Simmetopia/semester_02/README.md

# semester_02
2016 Semester Project for 10

# 07-10-2016 - 
###SIMON
  Jeg har nu lagt vores GUI op på git. Lav endelig pull requests hvis i finder noget som enten bygger videre, eller gør det bedre.
# 27-11-2016
###Simon og Emil
Lidt opdateret GUI(mangler megetarbejde endnu). Vi har lavet vores seriel kommunikation og lidt af logikken som skal være på arduinoen.
##TO DO:
1. Vi skal have lavet logikken færdig til arduino programmet
2. Protocollen skal skrives færdig
     
[Hent denne pakke til Arduinos IDE](https://github.com/maniacbug/StandardCplusplus)
   
eksempel på en streng hvor der skal tændes for 3 elementer:
"!,S,1,12:45,N,3,12:55,N,6,13:15\n"

#29-11-2016
###Simon
skrevet mere til PC program(se PCkode), som nu kan oprette scenarier og gemme dem i en dynamisk vector.
##TO DO mere her:
1. denne opsættelses process skal kunne gennem den streng vi modtager.
2. den skal også kunne oprette en streng som sendes serielt.
