Simmetopia/semester_02/Rapport/simon_rapport.tex

\documentclass[11pt]{article}
\usepackage{graphicx}
\usepackage{siunitx}
\usepackage{cleveref}
\usepackage{keyval,kvoptions,fancyvrb,float,ifthen,calc,ifplatform,pdftexcmds,etoolbox,lineno}
\usepackage[utf8]{inputenc}
\usepackage[danish]{babel}
\usepackage[left=25mm, right=25mm, top=25mm, bottom=25mm]{geometry}
\usepackage{amsthm}
\setlength\parindent{0pt}
\usepackage{dcolumn}
\usepackage{minted}
\usepackage{setspace}

\title{Rapport}

\begin{document}

\maketitle
\section*{Resumé}
\vfill
\pagebreak

\section*{Abstract}
\vfill
\pagebreak

\tableofcontents
\vfill
\pagebreak

\section{Forord}
\vfill
\pagebreak

\section{Indledning}
\vfill
\pagebreak
\section{Projektformulering \& Afgrænsning}
%Tabeloversigt over hovedansvarsområder for projektdeltagerne
\vfill
\pagebreak

\section{Systembeskrivelse}
\vfill
\pagebreak

\section{Krav}
\vfill
\pagebreak

\section{Smart Morning System (SMS) - Projekt Beskrivelse}
\subsection{Projektgennemførelsen}
\subsection{Metode}
\subsection{Specifikation \& Analyse}
\subsection{Arkitektur}
\subsection{Design, Implementering \& Test (HW/SW)}
\subsection{Resultater \& Diskussion}
\subsection{Opnåede erfaringer}
\subsection{Fremtidigt arbejde \& Perspektivering}
\vfill
\pagebreak

\section{Konklusion}
\vfill
\pagebreak

\section{Referencer}
\vfill
\pagebreak

\end{document}
