Simmetopia/semester_02/Rapport/ChristianLatex/DokumentationIndledning.pdf

## hahahaahah grimme

Christian Bondesen - 201511621

4. januar 2017

## 1 Indledning

Smart Morning System er et system der vil gøre det lettere for den almene dansker, at f˚a en dejlig morgen. Systemet vil best˚a af nogle forskellige hardware- og softwaredele. Dette produkt vil best˚a af en PC-applikation, en X-10 modtager og en X-10 sender og et DE2 board. X-10 hardware- og softwaren vil følge X-10 protokol¹
, yderligere er de ogs˚a tilkoblet lysnettet p˚a forbrugerens hjem. Det er ogs˚a tilgængeligt at bruge en Graphical User Interface til at styre et brugervalgt scenarie. Disse scenarier kan best˚a af forskellige enheder eksempelvis, en lampe, en radio eller en kaffemaskine. Det vil ogs˚a være muligt at sætte alle enheder sammen og definere et specifikt tidspunkt hvorp˚a det scenarie vil p˚abegyndes til valgte tidspunkt.

## Læsevejledning

For at kunne læse og forst˚a denne projektdokumentation, anbefales det at følgende vejledning. Mange udtryk, forkortelse og sprogligevendinger er beskrevet herunder. Det vil gøre det mere overskueligt og skaber bedre forst˚aelse.

1
indsæt

1

Term | Beskrivelse | Surrogat
X-10 modtager | X-10 protokolens modtagerdel der læ- ser p˚a lysnettet og signalere til ATme- ga2560 om der er et logisk højt eller lavt | Modtager, 120 kHz Carrier-detector
X-10 sender | X-10 protokolens senderderdel der sen- der en bitkode sikkert ud p˚a lysnettet | Generator, 120 kHz carrier-generator
GUI | Graphical User Interface | brugerflade, Grafisk brugerflade
Zero-cross | X-10 protokolens Zero-cross detector, den der detekterer hvert zero cross p˚a lysnettet | ZeroX
burst | 120 kHz sendes fra ATmega2560 eller Analog-Discovery | 120 kHz
Arduino | Microcontrollerne til modtager og sen- der | ATmega2560, Microcontroller
Lysnet | 18VAC signal | El-nettet
Nulgennemgang | Hvergang der sinussignalet rammer 0 | zero cross

Tabel 1: Tabel over termer der fremmer forst˚aelse hos læseren af projektdokumentation

2
