Simmetopia/semester_02/Dokumentation/Dokumentation.pdf

Aarhus School of Engineering

2.SEMESTERPROJEKT

E2PRJ2

gruppe 10

# Smart Morning System - SMS

20. december 2016

Forfattere:
201511621 Christian Brandstrup Bondesen 201511621 Emil Celik
201408914 Marc Auphong Bui
2015xxxxx Rasmus Lund
201406253 Simon Egeberg

Vejleder:
Kim Bjerge


## Indhold

1 Indledning | 2
2 Kravspecifikation | 3
3 Arkitektur | 4
4 Hardware-design, implementering & modultest | 5
5 Software-design, implementering & modultest | 6
6 Integrationstest (HW/SW) | 7
7 Accepttest | 8
8 Bilag | 9

## 1 Indledning

## 2 Kravspecifikation

## 3 Arkitektur

## 4 Hardware-design, implementering & modultest

### 4.1 Design (HW)

### 4.2 Implementering (HW)

### 4.3 Modultest (HW)

## 5 Software-design, implementering & modultest

### 5.1 Design (SW)

### 5.2 Implementering (SW)

### 5.3 Modultest (SW)

## 6 Integrationstest (HW/SW)

## 7 Accepttest

## 8 Bilag
