Simmetopia/semester_02/(threads)

Thread 50 (2016-12-14):

burstOn(); - skal den være i en seperat .h fil?

donbuibui, 2016-12-14:
Jeg tænkte på om den overhovedet kunne kaldes hvis den er inde i ReadASCIIString.ino.ino

Simmetopia, 2016-12-15:
#dude!
##Vi kan kun bruge Arduino kode i .ino filen. Jeg lukker problemet igen

Closed 2016-12-15.
