Simmetopia/semester_02/(list of files, drawings)

Other design files:
translationProtocol/fumlebræt.fzz
