Simmetopia/semester_02/KodeTilHardware/Modtager/SWmodtager/SWmodtager.ino

#include <StandardCplusplus.h>
#include <system_configuration.h>
#include <unwind-cxx.h>
#include <utility.h>
#include <vector>
#include <list>
#include "logik.h"
#define ZEROCROSS 2
#define d_in 3
#define redLed 32
#define yellowLed 33
#define greenLed 31


int dataIn();
void writeToVector(unsigned char);
logik l1;
int  count = 0;
const std::vector<int> constBuff = {1, 1, 1, 0};
std::vector<int> tempBuff;
std::vector<int> bufferVec;




void setup() 
{
  Serial.begin(9600);
  pinMode(redLed, OUTPUT);
  pinMode(yellowLed, OUTPUT);
  pinMode(greenLed, OUTPUT);
  pinMode(ZEROCROSS, INPUT);
  pinMode(d_in, INPUT);
}



void loop() 
{
  digitalWrite(redLed, LOW);
  digitalWrite(greenLed, HIGH);
  

  if(digitalRead(ZEROCROSS) == HIGH)
  {
    digitalWrite(greenLed, LOW);
    digitalWrite(yellowLed, HIGH);
    switch (count) 
    {
      case 0:
        tempBuff.push_back(dataIn()) ;
        break; 

      case 1:  
        tempBuff.push_back(dataIn());
        break;

      case 2:
        tempBuff.push_back(dataIn());
        break;

      case 3:
        tempBuff.push_back(dataIn());
        break;

      default:
        // do something
        break;
    }
    count ++;

    if( tempBuff == constBuff )
    { 
      int count2_=0;
        while(count2_ < 14)
        {
          if(digitalRead(ZEROCROSS) == HIGH)
          {
            bufferVec.push_back(dataIn() );
            count2_++;
          } // end inner if

          digitalWrite(redLed,HIGH);
          
        } // end while
        l1.readToVectorModtager(bufferVec);
        Serial.println(l1.binaryConverter() );
        bufferVec.clear();
        digitalWrite(redLed,LOW);

     } // end main if

  if(count > 4)
  {
      count = 0;
      tempBuff.clear();
      digitalWrite(yellowLed, LOW);

  }
  }
}

int dataIn(){

if(digitalRead(d_in) == HIGH)
{
  return 0;
}
else return 1;
}


  
