Simmetopia/semester_02/(commit log)

2016-11-29 skal tilføjes
    [fumlebræt.fzz]
2016-11-30 fikset resten af arduino og cpp kode
2016-12-05 sammensat de to hardwares
2016-12-05 QWidgetList
    Fik fikset problemet hvor den ikke gemte en streng
    [mainwindow.cpp]
2016-12-07 Det er stadig lidt
    Har problemer til at skrive til filen nu
    og læse den korrekt
    [mainwindow.cpp]
2016-12-08 attachInterrupt try
    Har prøvet at bruge attachInterrupt() og har desuden lavet nogle små
    ændringer
2016-12-08 Så der fstream
    fuck jeg er god
2016-12-08 1 ms burst virker, og registrerer de rigtige steder
    Registrerer ved hver logisk change og sender et 1 ms burst ud.
2016-12-13 ændret interrupt og burst funktioner
    burstOn(); bruges til at aktiverer interrupt og burst i 1 ms og sætte
    zeroState til 1
2016-12-13 Ny interrupt og zero cross
    Zero cross virker i hardwaren som den skal, s[ nu interrupter vi nu kun
    på RISING, og zerostate er ligeledes fjernet.
2016-12-13 testTilsenderLogik på arduino
    SWAAAAG
2016-12-13 lavet funktions prototype til indlæsning af binær streng
2016-12-14 Tilføjet det midlertidig kode Simon lavede til i dag
    - Tilføjet det midlertidig kode Simon lavede til i dag
    - Nu ligger den dog i mappen der tilsvarer navnet på filen, da Arduino
    IDE ikke ville åbne eller flytte filer hvis filnavn og mappenavn ikke
    stemmer overens
2016-12-16 Tilføj alarm
    Implementeret en liste af enheder i opretscenarie. Når trykker på
    knappen "Tilføj Enhed" enhedslisten fra "Enhedshåntering" loadet ind i
    den liste der er i opretscenarie
2016-12-20 Rettet framework til
    \section*
2016-12-26 Lavet blokbeskrivelse
    Mangler noget tekst til de enkelte blokke, samt signalbeskrivelse
2017-01-04 ledong
    sdfs
